emnik/Arduino_GSM_Thermostat/Parts_list.md

1. Arduino MEGA 2560 r3
https://www.arduino.cc/en/Main/arduinoBoardMega2560

2. Adafruit I2C Controlled + Keypad Shield Kit for 16x2 LCD
https://www.adafruit.com/products/715

3. Arduino GSM/GPRS Shield
http://www.tinyosshop.com/index.php?route=product/product&product_id=464

4. Wall Adapter Power Supply 9VDC 1A - European Plug
http://www.tinyosshop.com/index.php?route=product/product&product_id=259

5. 4 Channel 5V Relay Board Module
http://www.ebay.com/itm/Keyes-5V-4-Channel-Relay-Module-MD-007-250V-AC-30V-DC-Funduino-Flux-Workshop-/122209202186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

6. DS18B20 Programmable Resolution 1-Wire Digital Thermometer
https://www.maximintegrated.com/en/products/analog/sensors-and-sensor-interface/DS18B20.html

7. 1K Rotary Potentiometer with knob
http://www.ebay.com/itm/1K-ohm-Carbon-Potentiometer-6mm-Round-Shaft-Rotary-Taper-RV24YN20S-B102-w-Knob-/122049713186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

8. LED DIFFUSED RGB common anode 4-PINS F5 5MM
http://www.ebay.com/itm/10Pcs-LED-DIFFUSED-RGB-common-anode-4-PINS-F5-5MM-Super-Bright-Bulb-Lamp-/301980728032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

9. Dupont cables
http://www.ebay.com/itm/120Pcs-Male-Female-Dupont-wire-cables-jumpers-10-20-30cm-2-54MM-1P-For-Arduino-/182047669137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

For the case:

10. Panel Mount 2.1mm DC barrel jack
https://www.adafruit.com/products/610

11. Red & Black Flexible Silicone Wire Cable 22 AWG for Power connections
http://www.ebay.com/itm/1-2-5-10M-Meter-Red-Black-Flexible-Silicone-Wire-Cable-10-12-14-16-18-20-22-AWG-/291880071129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

12. Protoboard

13. Plastic Enclosure Case
