emnik/Arduino_GSM_Thermostat/gsm_thermostat.pdf

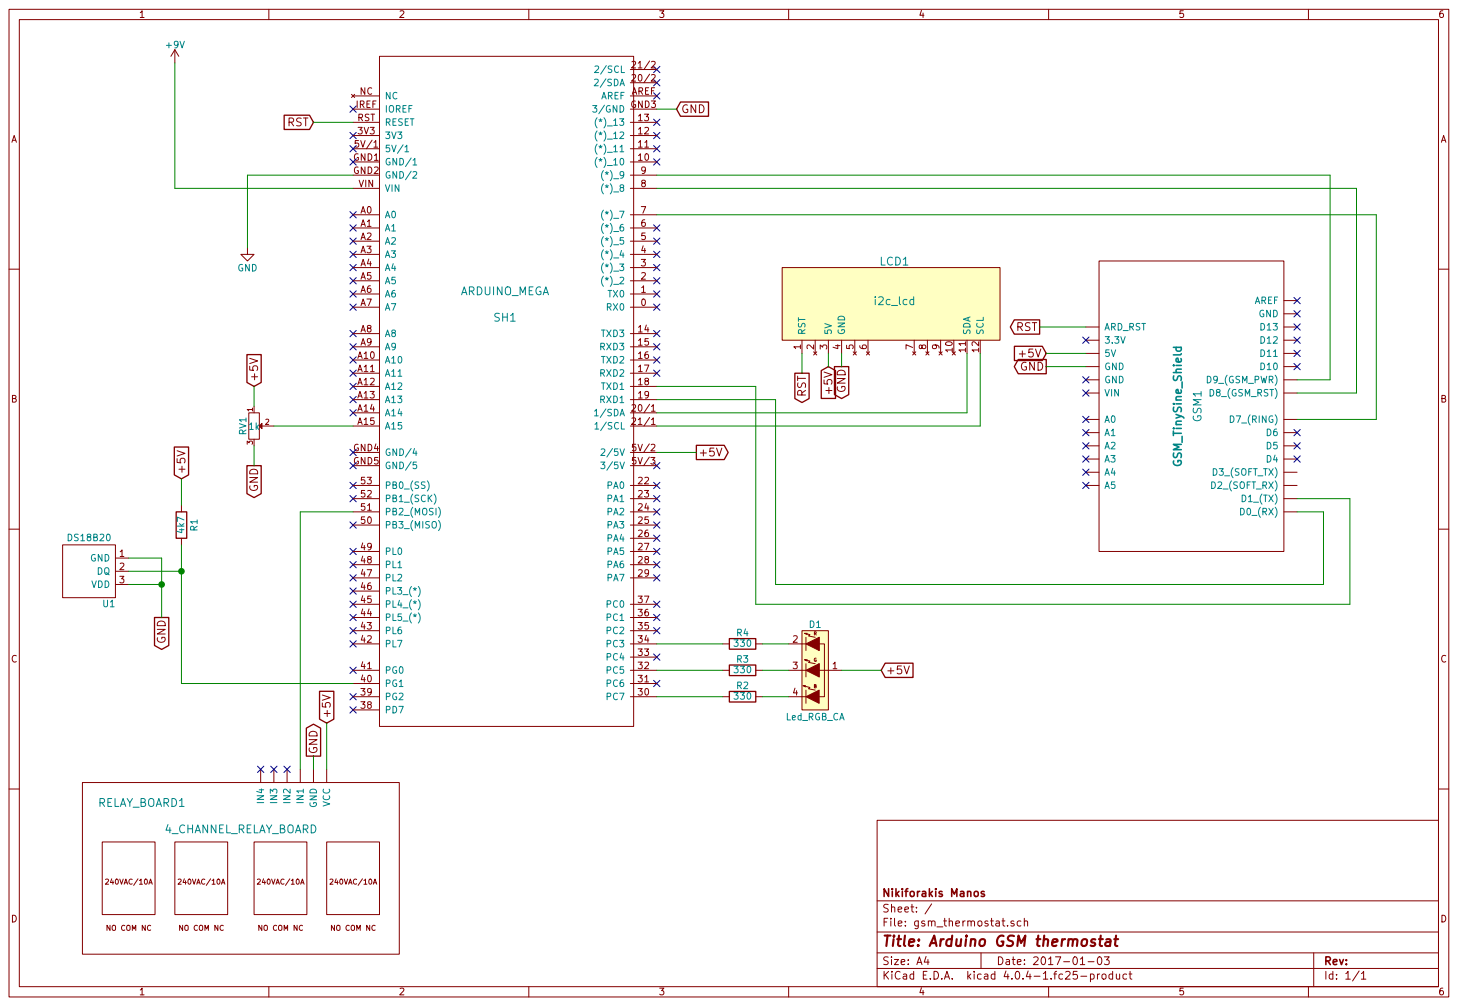
[picture p4: page 1]

Id: 1/1 Title: Arduino GSM thermostat
